Eric-Avram/DM542T_Modbus_Controller/AvrTimerPWM/README.md

# AvrTimerPWM

Variable-frequency hardware PWM for the ATmega328P (Arduino Nano, Uno), generated directly by Timer1 on pins 9 and 10.

Unlike `analogWrite()`, the frequency can be set by the user and changed while the timer is running. Frequency changes are synchronized with the timer so that no pulses are lost or added, which makes the library suitable for the STEP input of stepper motor drivers.

## Requirements
* ATmega328P. Other microcontrollers are rejected at compile time. The frequency figures below assume a 16 MHz clock.
* Timer1 is used exclusively by this library. Do not combine it with `analogWrite()` on pins 9 and 10, the Servo library, or any other code that uses Timer1.
* The library defines `TIMER1_OVF_vect`, so a sketch can't define its own handler for it.

## Usage
```cpp
#include <AvrTimerPWM.h>

AvrTimerPWM pwm(5000.0f, 0.5f);   // 5 kHz, 50% duty

void setup() {
   pwm.setPWMMode(PWM_MODE::FAST_PWM_PH_CORRECT);   // configures and starts the timer
   pwm.pwmOn(9);                                    // connect the output to pin 9
}

void loop() {
   pwm.rampPWMFrequency(10000.0f, 2000.0f);         // move toward 10 kHz at 2000 Hz/s
}
```

The constructors only store the values. Timer registers are written from `setup()` onwards, because the Arduino core reconfigures Timer1 before `setup()` runs. Call `setPWMMode()` or `setPWMFrequency()` in `setup()` to apply them.

## API
| Function | Description |
|---|---|
| `AvrTimerPWM(frequency, dutyCycle)` | Stores the frequency in Hz and the duty cycle (0.0 to 1.0) |
| `AvrTimerPWM()` | Same, with 2000 Hz and 50% duty |
| `setPWMMode(mode)` | Sets the waveform mode and configures the timer. Returns the actual frequency |
| `setPWMFrequency(freq, lo, hi)` | Clamps the frequency to the limits and reconfigures the timer, restarting the counter. Returns the actual frequency |
| `changePWMFrequency(freq, lo, hi)` | Changes the frequency without restarting the timer. Returns the actual frequency, or 0 if rejected |
| `rampPWMFrequency(target, accel, lo, hi)` | Call every `loop()`. Moves the frequency toward the target at `accel` Hz/s (default 500). Returns true while ramping, false when on target or if the request failed |
| `setPWMDuty(duty, pin)` | Sets the duty cycle (0.0 to 1.0) on pin 9, pin 10, or both with pin 0 |
| `pwmOn(pin)` / `pwmOff(pin)` | Connects or disconnects pin 9, pin 10, or both with pin 0. `pwmOn()` is refused until the timer is configured |
| `setTimer(mode, freq)` | Low-level timer configuration, without frequency limits. Returns the actual frequency, or 0 if rejected |
| `getPwmFrequencyActual()` / `getPwmFrequencyRequested()` | Last actual and last requested frequency |
| `getPwmDuty9()` / `getPwmDuty10()` | Stored duty cycle per pin |
| `getPwmMode()` / `getPwmTop()` / `getPwmCS()` | Current mode, TOP value and clock select bits |
| `getPwmStatus()` | Connected pins: bit 0 = pin 9, bit 1 = pin 10 |
| `isPwmConfigured()` | True once the timer has been configured |
| `isValidFrequencyRange(lo, hi)` | True if both limits are positive and `lo` is below `hi` |
| `getError()` / `resetError()` | Reads or clears the stored error |
| `getWarning()` / `resetWarning()` | Reads or clears the stored warning |

### Modes
| `PWM_MODE` | AVR mode | Frequency | Duty |
|---|---|---|---|
| `PWM_MODE::FAST_PWM_PH_CORRECT` | 8, Phase and Frequency Correct | $f_{clk} / (2 \cdot N \cdot TOP)$ | Yes |
| `PWM_MODE::PH_CORRECT` | 10, Phase Correct | $f_{clk} / (2 \cdot N \cdot TOP)$ | Yes |
| `PWM_MODE::FAST_PWM` | 14, Fast PWM | $f_{clk} / (N \cdot (TOP + 1))$ | Yes |
| `PWM_MODE::CTC` | 12, CTC | $f_{clk} / (2 \cdot N \cdot (TOP + 1))$ | No |
| `PWM_MODE::NORMAL` | 0, Normal | $f_{clk} / (65536 \cdot N)$ | No |

$N$ is the prescaler: 1, 8, 64, 256 or 1024.

`changePWMFrequency()` and `rampPWMFrequency()` only work in `PWM_MODE::FAST_PWM_PH_CORRECT`, the mode used for on-the-fly changes.

## Errors and warnings
An error means the request was rejected and the output didn't change. The first error is kept until `resetError()`.

A warning means the request was applied, but had to be adjusted. Only the most recent warning is kept, until `resetWarning()`.

| `PWM_ERROR` | Cause |
|---|---|
| `NONE` | No error |
| `PWM_UNCONFIGURED` | The timer hasn't been configured yet |
| `PWM_MODE_INCORRECT` | The current mode doesn't support on-the-fly frequency changes |
| `FRQ_TOO_LOW` | The frequency is 0 or negative, or too low for any prescaler |
| `FRQ_OUT_OF_BOUNDS` | The frequency is too high for the selected mode |
| `PRESCALER_OUT_OF_BOUNDS` | The frequency doesn't fit the current prescaler |
| `FRQ_HI_LO_INVALID` | `changePWMFrequency()` received a lower limit above the upper limit |
| `ACCEL_INVALID` | The ramp acceleration is 0 or negative |
| `PIN_INVALID` | The pin isn't 0, 9 or 10 |

| `PWM_WARNING` | Cause |
|---|---|
| `NONE` | No warning |
| `FRQ_CONSTRAINTED_LO` | The frequency was raised to the lower limit |
| `FRQ_CONSTRAINTED_HI` | The frequency was lowered to the upper limit |
| `FRQ_HI_LO_INVALID` | The limits were invalid, so the defaults were used. `rampPWMFrequency()` clears this once it receives valid limits |
| `DUTY_CONSTRAINED` | The duty cycle was limited to the 0.0 to 1.0 range |

## Limits
* Pins 9 and 10 share Timer1, so they always run at the same frequency. The duty cycle is set per pin.
* The frequency limits default to 125 Hz and 20 kHz. Pass `lo` and `hi` to use a different range.
* `changePWMFrequency()` keeps the current prescaler and requires $40 \le TOP \le 65535$. With prescaler 1 that is about 122 Hz to 200 kHz. A frequency outside that range is rejected.
* `changePWMFrequency()` applies a new frequency within about one PWM period.
* `rampPWMFrequency()` has the same prescaler and TOP limits as `changePWMFrequency()`. Each update counts at most 10 ms of elapsed time, so a slow `loop()` makes the ramp slower instead of causing a jump.
* Starting or stopping the output with `pwmOn()` / `pwmOff()` isn't synchronized with the timer and can produce one partial pulse.
* `attach()` is not implemented yet. Only Timer1 is supported.

## License
MIT, see [LICENSE](LICENSE).
