Eric-Avram/DM542T_Modbus_Controller/Test-Results/default_f_500Hz_duty_50p.png

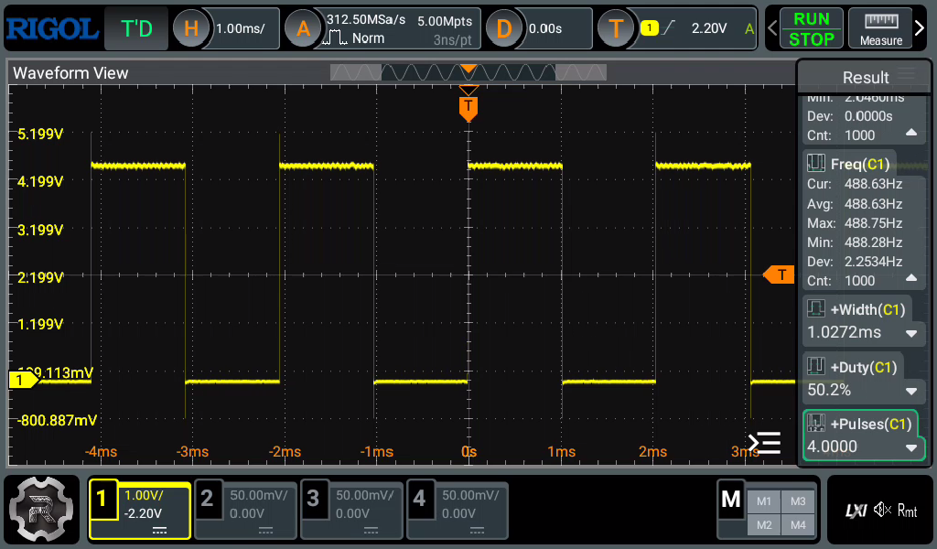
Test-Results/default_f_500Hz_duty_50p.png
