Eric-Avram/DM542T_Modbus_Controller/Test-Results/evidence_00_V01.png

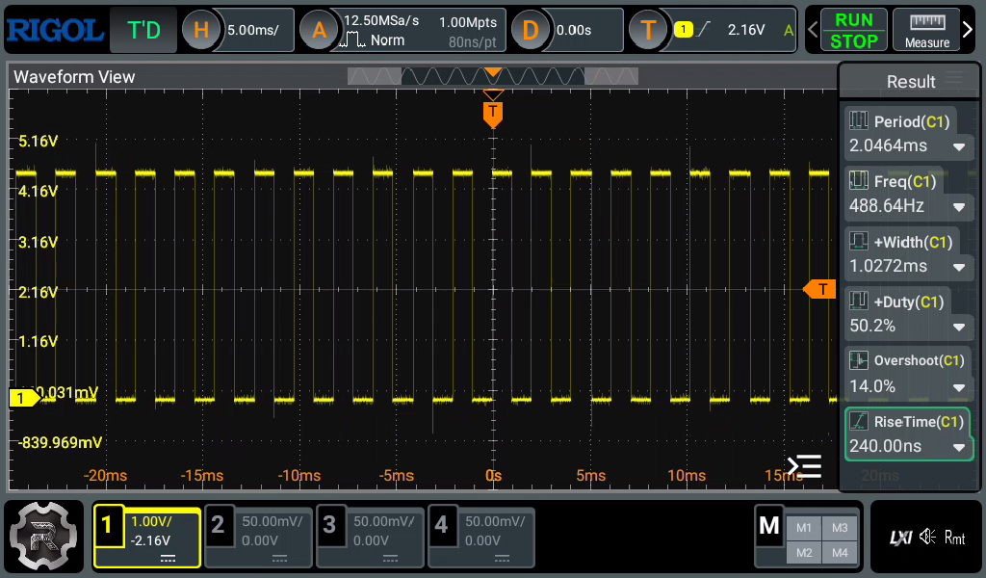
Test-Results/evidence_00_V01.png
