Eric-Avram/DM542T_Modbus_Controller/Test-Results/evidence_01_V02.png

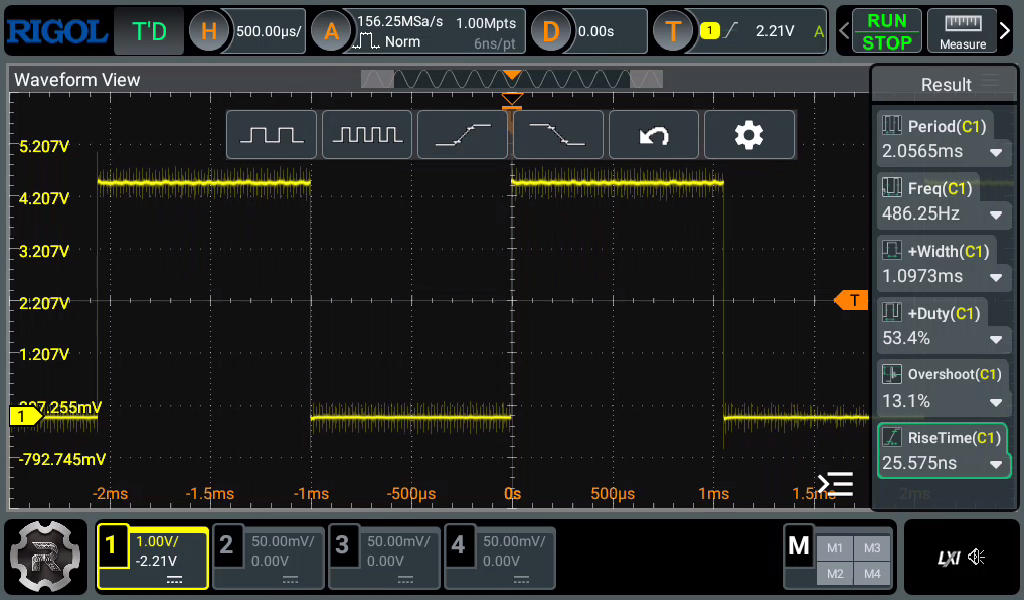
Test-Results/evidence_01_V02.png
