Eric-Avram/DM542T_Modbus_Controller/Test-Results/evidence_02_V03.png

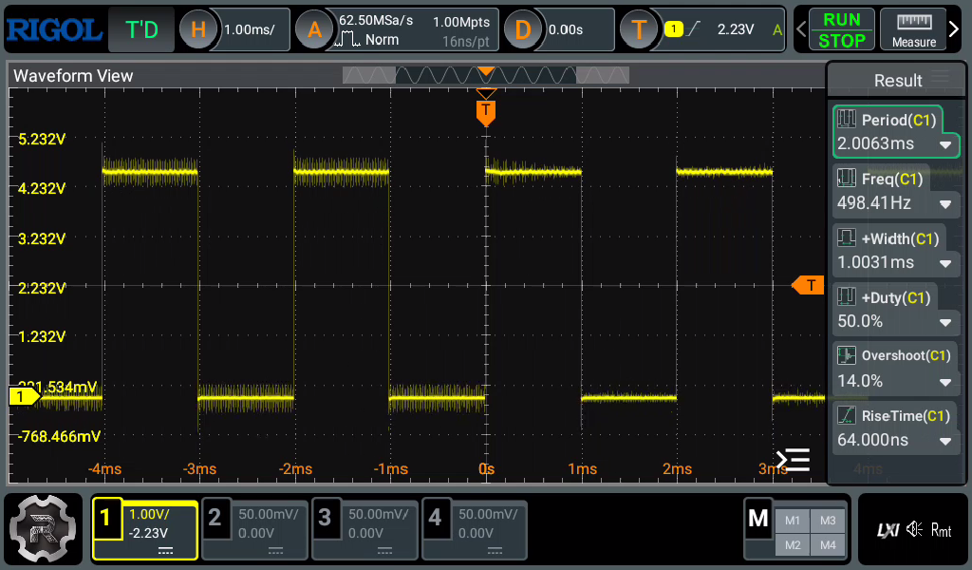
Test-Results/evidence_02_V03.png
