Eric-Avram/DM542T_Modbus_Controller/Test-Results/evidence_03_V04.png

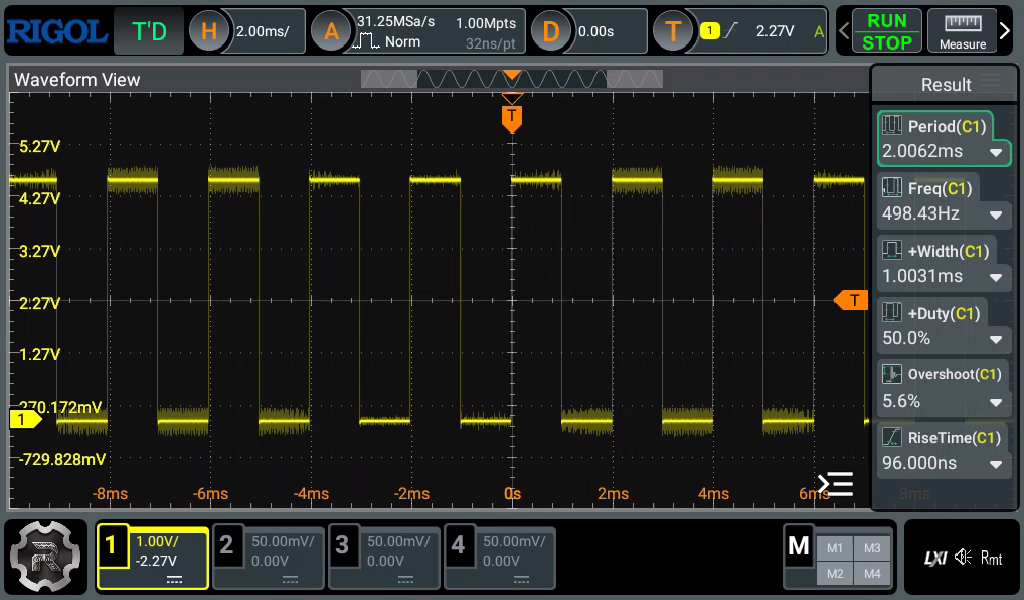
Test-Results/evidence_03_V04.png
