Eric-Avram/DM542T_Modbus_Controller/(commit log)

2026-10-26 First tests using analogWrite() default function.
    Initial tests. According to https://docs.arduino.cc/tutorials/generic/secrets-of-arduino-pwm/ this should be enough for most users wanting to generate some PWM signals
2026-10-28 Added more data and evidence. Tried Bit-Banging PWM
    * Added Test & Results doc to keep track of tests
    * Added PWM function that bit bangs a PWM, as per the data found in https://docs.arduino.cc/tutorials/generic/secrets-of-arduino-pwm/?queryID=undefined
    * Cleaned the code from unused blocks
    * Added some test pics.
2026-10-28 Documented current results on bit-banging vs analogWrite
    * Organised folder
    * Added current results and notes
2026-10-28 Update sketch to use Timer1 directly and prepared Modbus data
    * Added Modbus addresses for PWM duty, frequency and coils for turning on/off
    * Changed addresses format from DEC to HEX for easier referencing later
    * Added PWM namespace to store PWM related data
    * Added ADDR namespace to store Modbus addresses related data
    * Added pwmOn and pwmOff functions to connect/disconnect Timer 1 to pin 9, 10 or both
    * Added function prototypes for setting frequency and duty
    * Removed all code related to previous PWM generation methods
    * Currently set at fixed 500Hz 50% duty for testing
    [DM542T_Modbus_Controller.ino]
2026-10-29 V0.3 - Direct PWM control via Timer 1
    * Removed versioning header since the changelog is kept in the readme
    * Changed pwmON and pwmOFF functions to ternary operator since there is no point to use switch case yet.
    * Recorded evidence using direct PWM output
2026-11-03 Update Modbus addresses
    * Added more addresses based on the current design for controlling the motor.
    * Added params for PWM control (top, limits, cs, etc)
    * Added signal generation constraints (for my setup 122Hz to 20kHz is enough)
    * Changed pwm on / off functionality.
    ** PWM On/Off functions now only check if the command is correct and do bitwise operation on the status word.
    ** If everything OK, the functions call an updatePins() function that deals with changing chip port statuses and control
    [DM542T_Modbus_Controller.ino]
2026-11-03 Created evidence 03_V04 on new update
    * Tested the new methods on the Nano
    * Tested with 22Ohm resistor to reduce overshoot
    * Added information in test-results
2026-11-03 Update Control Method
    * Added function to wrap the control word for pwm on/off to avoid redundant code.
    * Deleted commented out code
    * Organised code
    [DM542T_Modbus_Controller.ino]
2026-11-04 Updated Timer Settings Algorithm
    * Added function that sets up the timer before usage.
    ** Sets all required registers
    ** Checks for the best prescaler value based on the current operation mode
    ** Sets pin modes
    ** Updates the timer registers in an atomic block to avoid interruptions during waveform generation.
    * Added helper functions for getting control word for waveform generation mode based on current operation mode
    * Added helper function for getting control word for OCR based on duty value and current operation mode
    [DM542T_Modbus_Controller.ino]
2026-11-07 Change frequency capability
    * Added function prototypes declarations.
    * Split frequency functions:
    ** setPWMFrequency() for initially setting the frequency, then also setting the timer on that frequency. This should be called in setup() or if the frequency never changes
    ** changePWMFrequency() which can be called while the Timer is already running. This should be called in loop() or on an interrupt.
    * Changed setPWMDuty to also apply the values to the registers
    * Added complete setTimer function
    * Added ISR for timer1 overflow in preparation for ramping functions
    * Added frequency data to modbus
    * Slight variable naming changes
    * Removed initial code for clearing the timer and used created f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
2026-11-07 Code cleanup & bug fixes
    * Removed old commented out code.
    * Fixed bug where setPWMDuty would constraint the value in the OCR register but store the unconstrainted one in the register. ( case when the duty is set to be higher than 100%).
    * Fixed bug where last requested frequency would not be recorded if current top == previous top
    * Fixed bug where duty would not be recorded if timer is not configured yet
    * Fixed a bug in the changePWMFrequency: the previous implementation would change the values whenever the program reached those instructions. This can lead to +- 1 step when driving stepper motors with hardly any way to record that. Now the frequency change is dependent on whether the new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
    [DM542T_Modbus_Controller.ino]
2026-11-08 Ported PWM Generation to its own library
    * Moved all the PWM functions from the sketch in its own library.
    For now it's not fully tested, just checked that it compiles correctly and basic functionality is working.
    /src is the stable compiling version, /lib-devel is the under testing lib version.
    * Commented out the old code using the functions instead of library.
    * Added keywords.txt for future
    [AvrTimerPWM.cpp, AvrTimerPWM.h, DM542T_Modbus_Controller.ino]
2026-11-09 Changed folder structure to required lib format
    * Renamed lib-devel folder to AvrTimerPWM
    * Moved src folder to AvrTimerPWM
    * Added CHANGELOG.md
    * Added README.md
    * Added LICENSE
    * Fixed small bug where, when doing a frequency change, if the change is done in a ramp, the ramp might sometimes get inverted at low frequencies. Bug caused by comparison of new TOP with previous TOP, now comparing with ICR1 instead.
    [AvrTimerPWM.cpp, AvrTimerPWM.h]
2026-11-10 Bug fixes & Improvements for the AvrTimerPWM Library
    * The changeFrequency() function was previously using a static variable to record the last millis for the computed frequency. This works well as long as there is only 1 PWM object, on the second one the 2 objects would share the variable, so changed that to a private member of the class instead.
    * Changed the global enums to enum classes to avoid any conflicts with other enums that might have the same name
    * Added isPWMConfigured()
    * Added default constructor
    * Moved the rampFrequency function from the sketch to the library.
    * Removed old commented out code from the sketch
    [AvrTimerPWM.cpp, AvrTimerPWM.h, DM542T_Modbus_Controller.ino]
2026-11-10 Error Handling
    * Added errors & warnings
    * Updated README
    * Updated keywords.txt
    * Re-arranged code for an easier read and added pragma region to organise it a bit.
    [AvrTimerPWM.cpp, AvrTimerPWM.h]
2026-11-11 Tested using an EthernetShield for adding ModbusTCP
    * Tested if it's possible to use an ENC28J60 ethernet shield as interface to use modbus tcp instead of modbus RTU. Unfortunately, this shield is using D10 for CS/SS, which is one of the PWM pins for Timer1.
    * Will drop modbusTCP for now and continue to develop modbusRTU
2026-11-11 Frequency Sweep Testing using Codesys on RaspberryPi
    * Added a small Codesys program that connects to the Arduino via ModbusRTU. (Raspberry Pi as Codesys host). Archive can be found under Testing Programs folder
    * Tested the frequency sweep.
    * Measured tests with oscilloscope
    * Measured tests with codesys trace
    * Added results in test&Results report
    * Generated diagrams based on the extracted data
    All these tests and data can be veiewed in the Test-Results folder and the diagrams can be found in Diagrams folder.
    The oscilloscope results (.csv files) have been compressed because of the filesize.
